veliertunc/industrial-comm-board/board.step

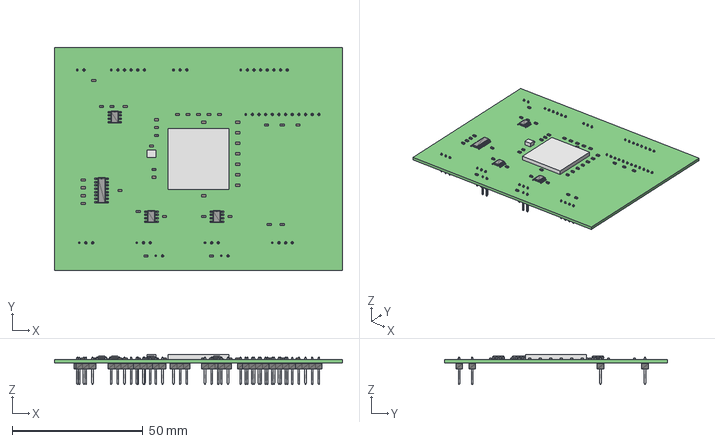
[picture p1: CAD file, 2026-11-03]
board.step
110.0 x 85.0 x 11.6 mm
