veliertunc/industrial-comm-board/output/pdf/industrial-comm-board.pdf

# STM32F746ZG / Industrial communication board

01 MCU and debug | 02 Power and clock | 03 Serial interfaces | 04 CAN and Ethernet | 05 Display, EEPROM and USB

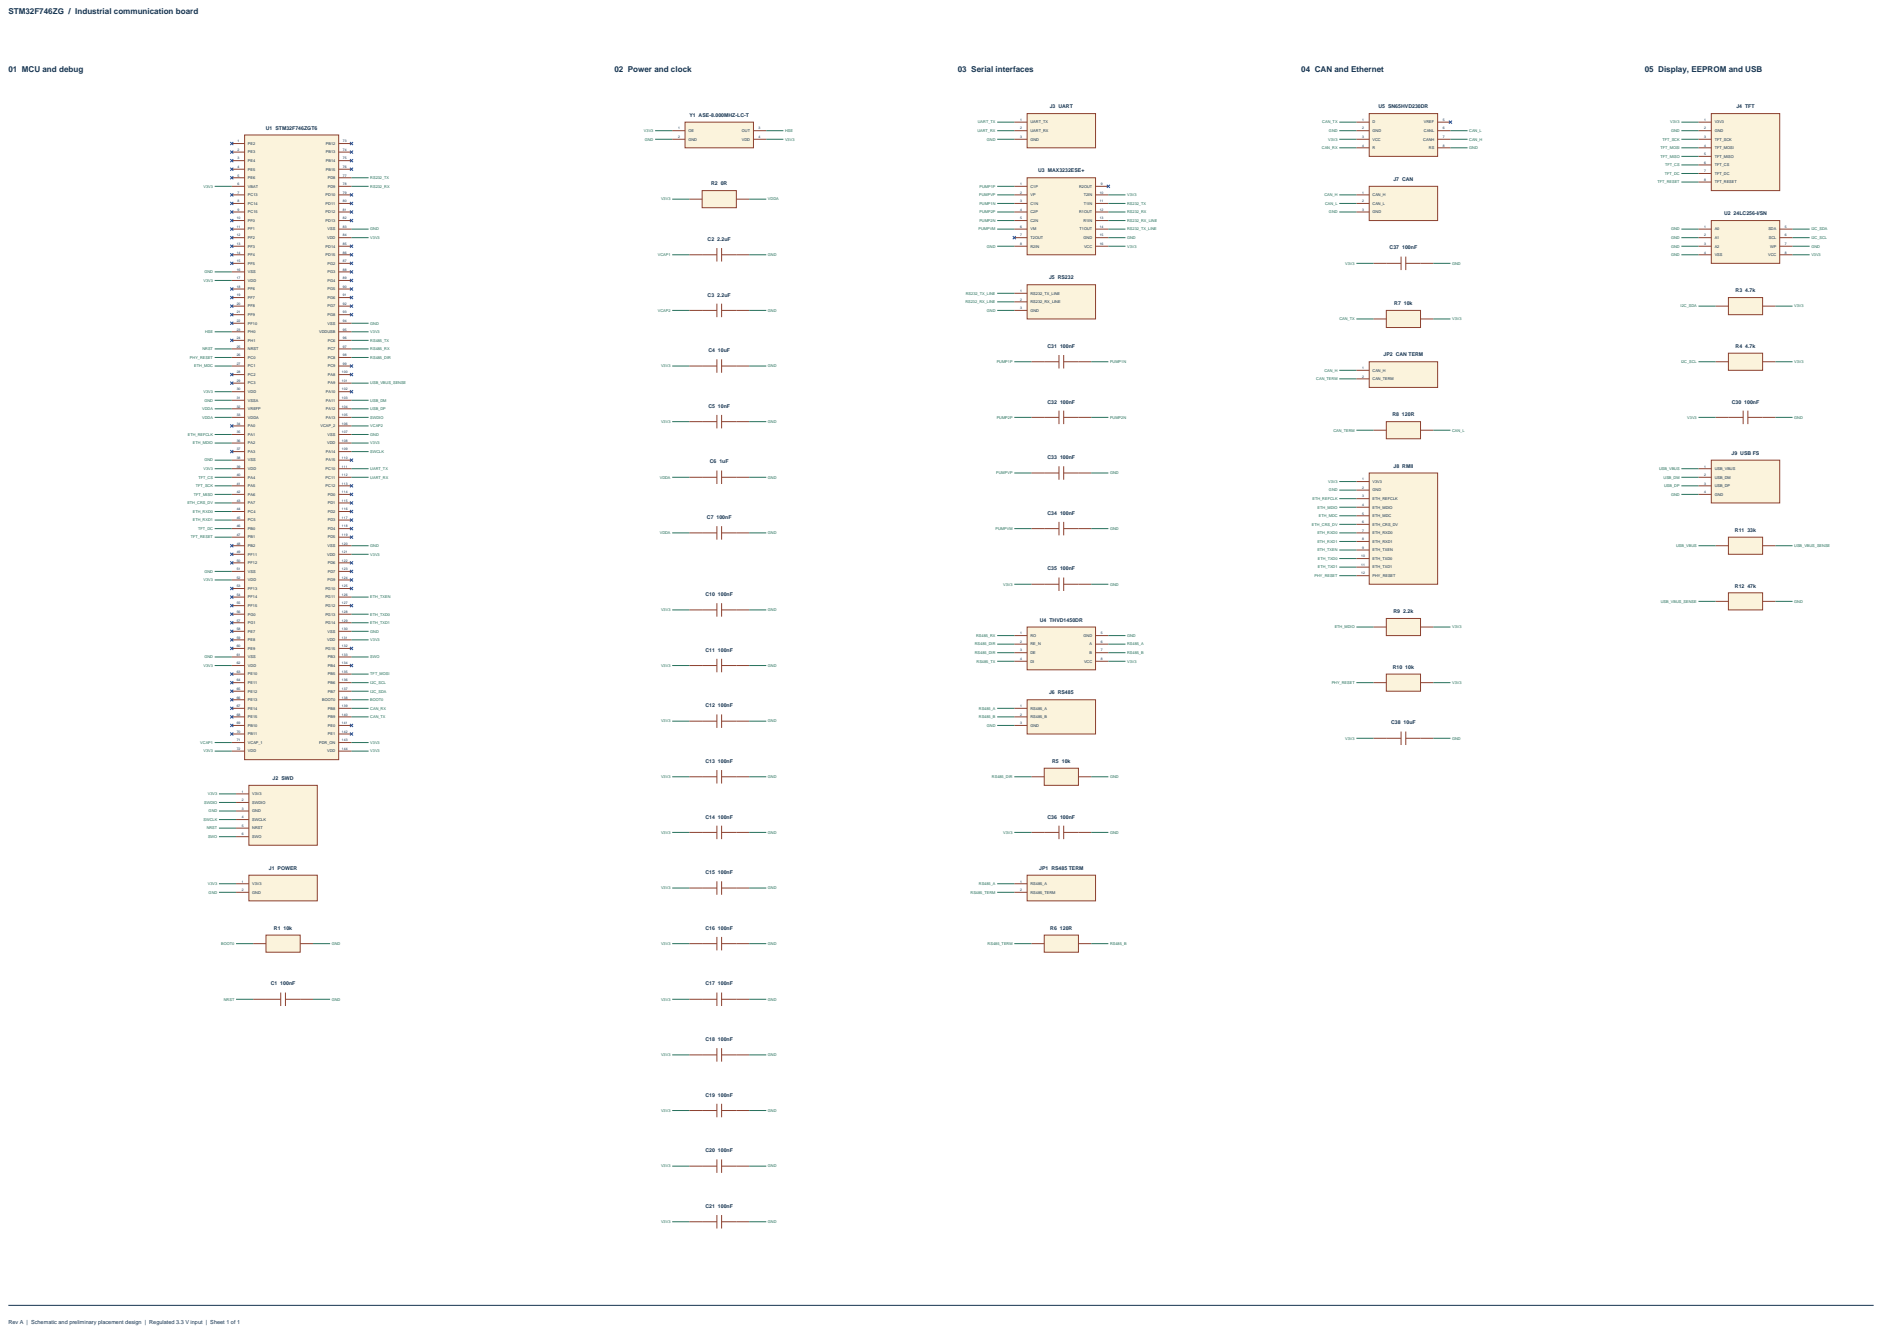
[picture p2: page 1]

Rev A | Schematic and preliminary placement design | Regulated 3.3 V input | Sheet 1 of 1
