veliertunc/industrial-comm-board/output/industrial-comm-board.kicad_sch

## KiCad design output/industrial-comm-board.kicad_sch (2026-11-03)

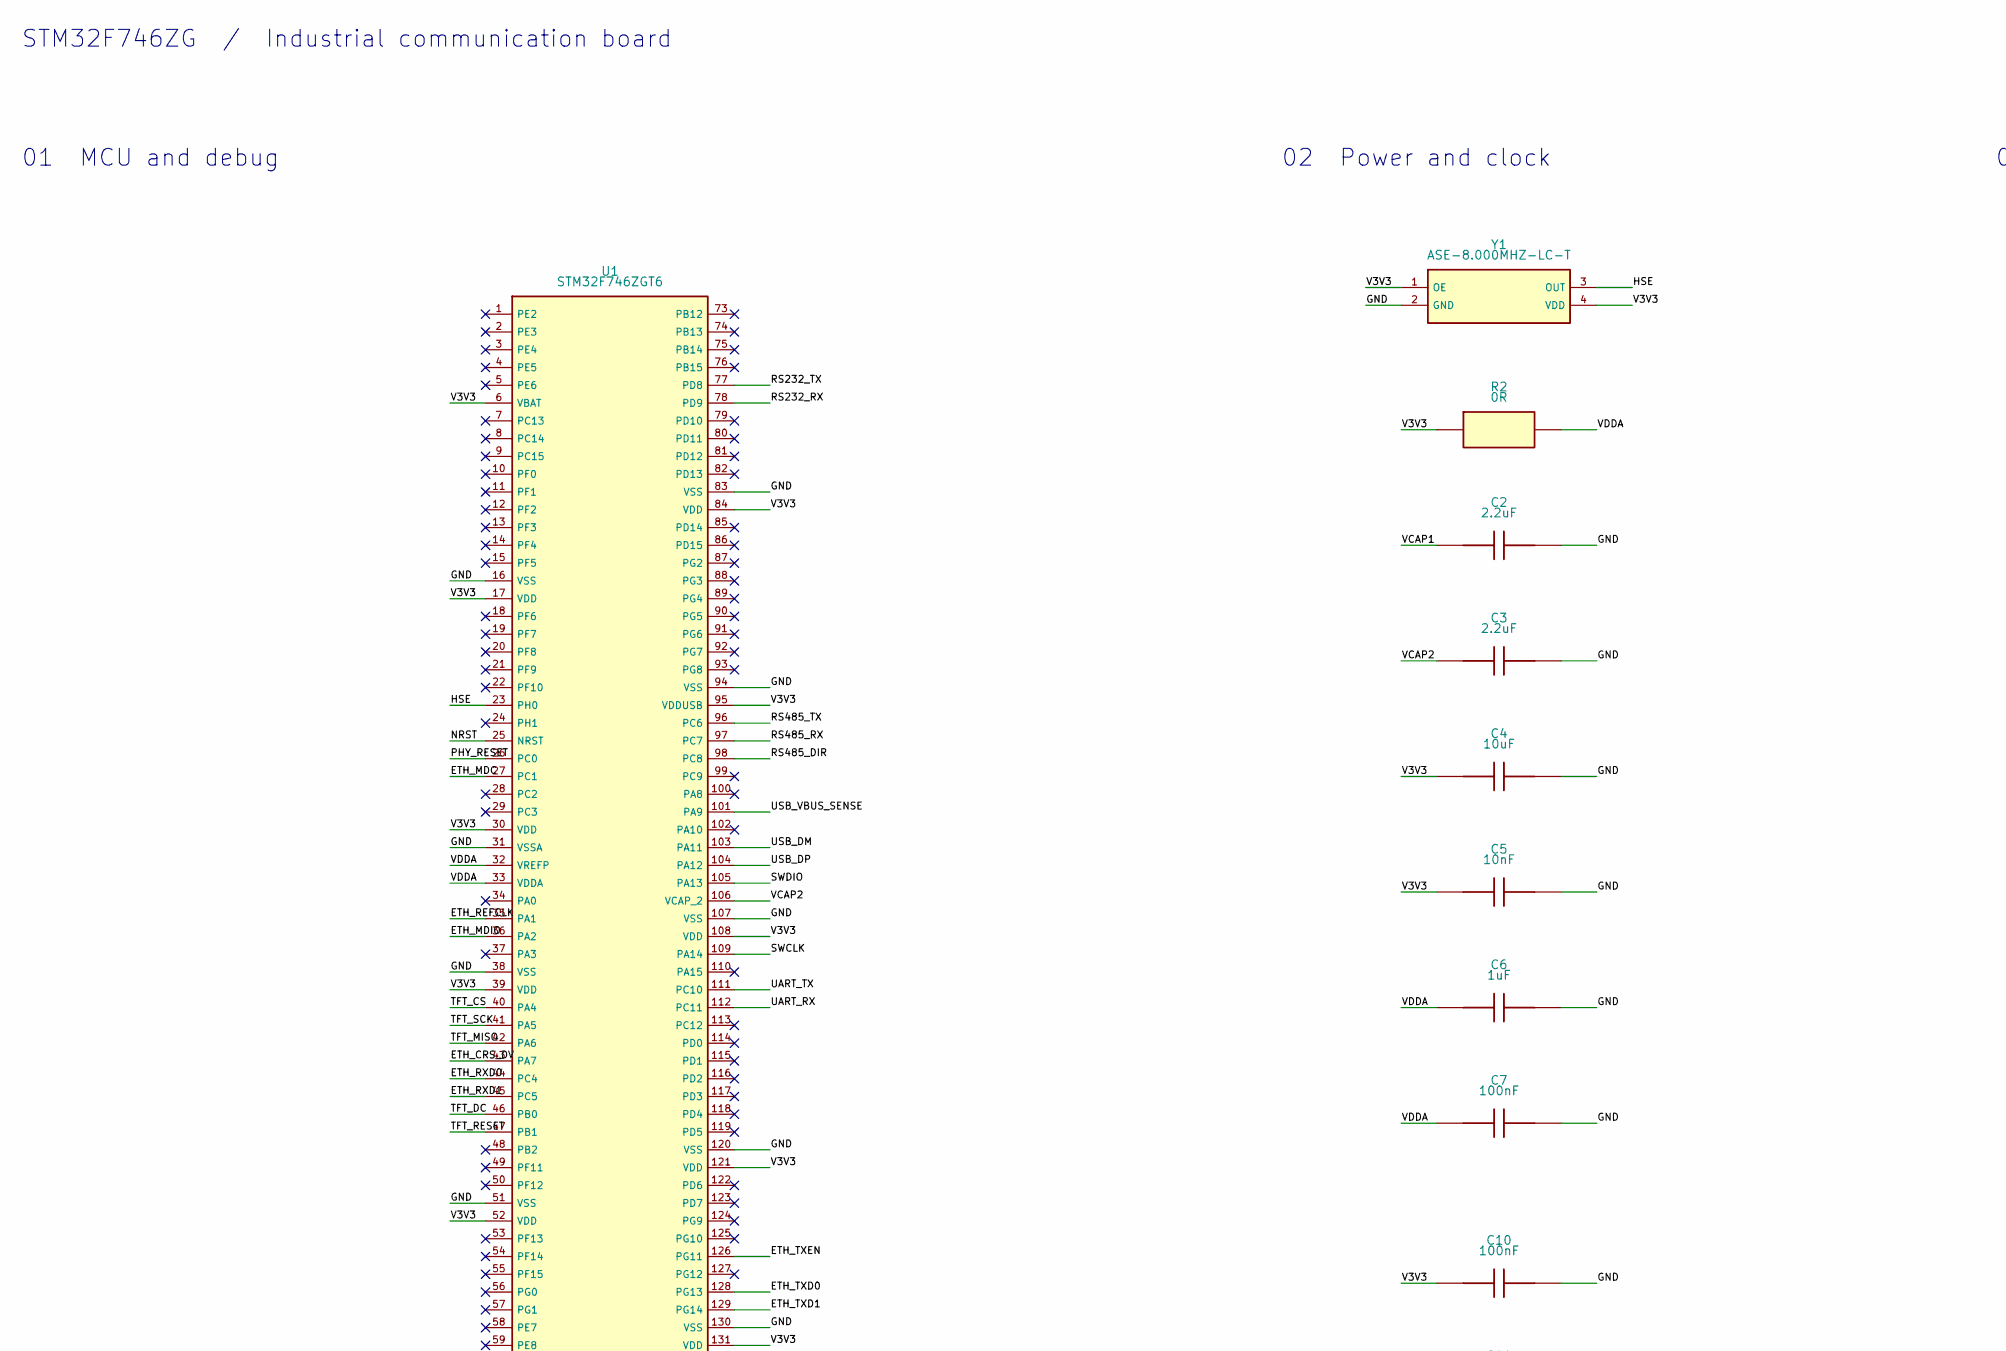
[picture p3: schematic industrial-comm-board.kicad_sch, part in row 1, column 1]

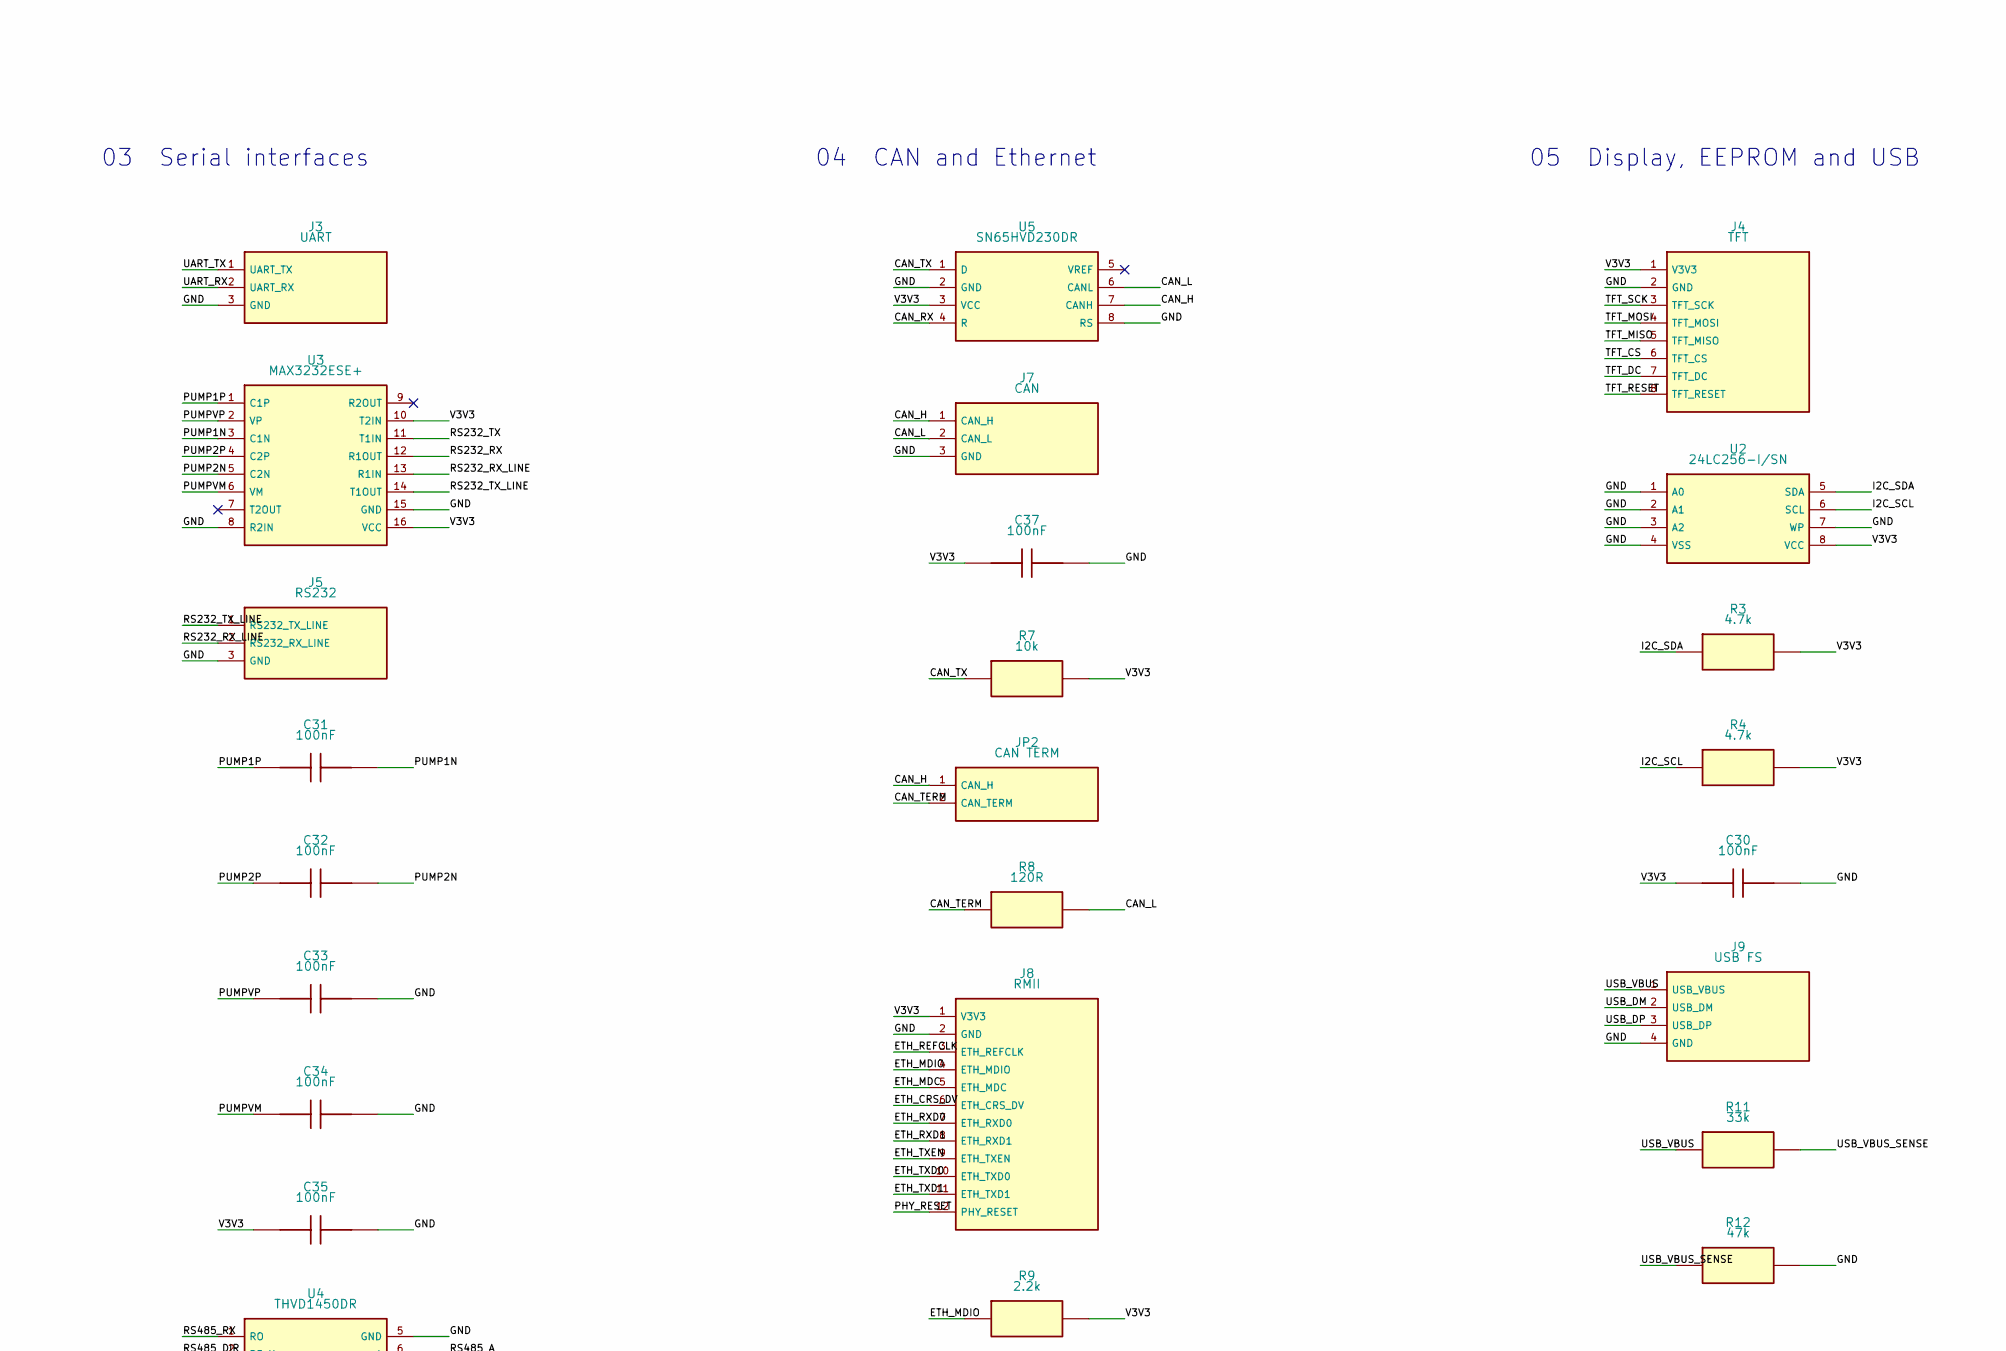
[picture p4: schematic industrial-comm-board.kicad_sch, part in row 1, column 2]

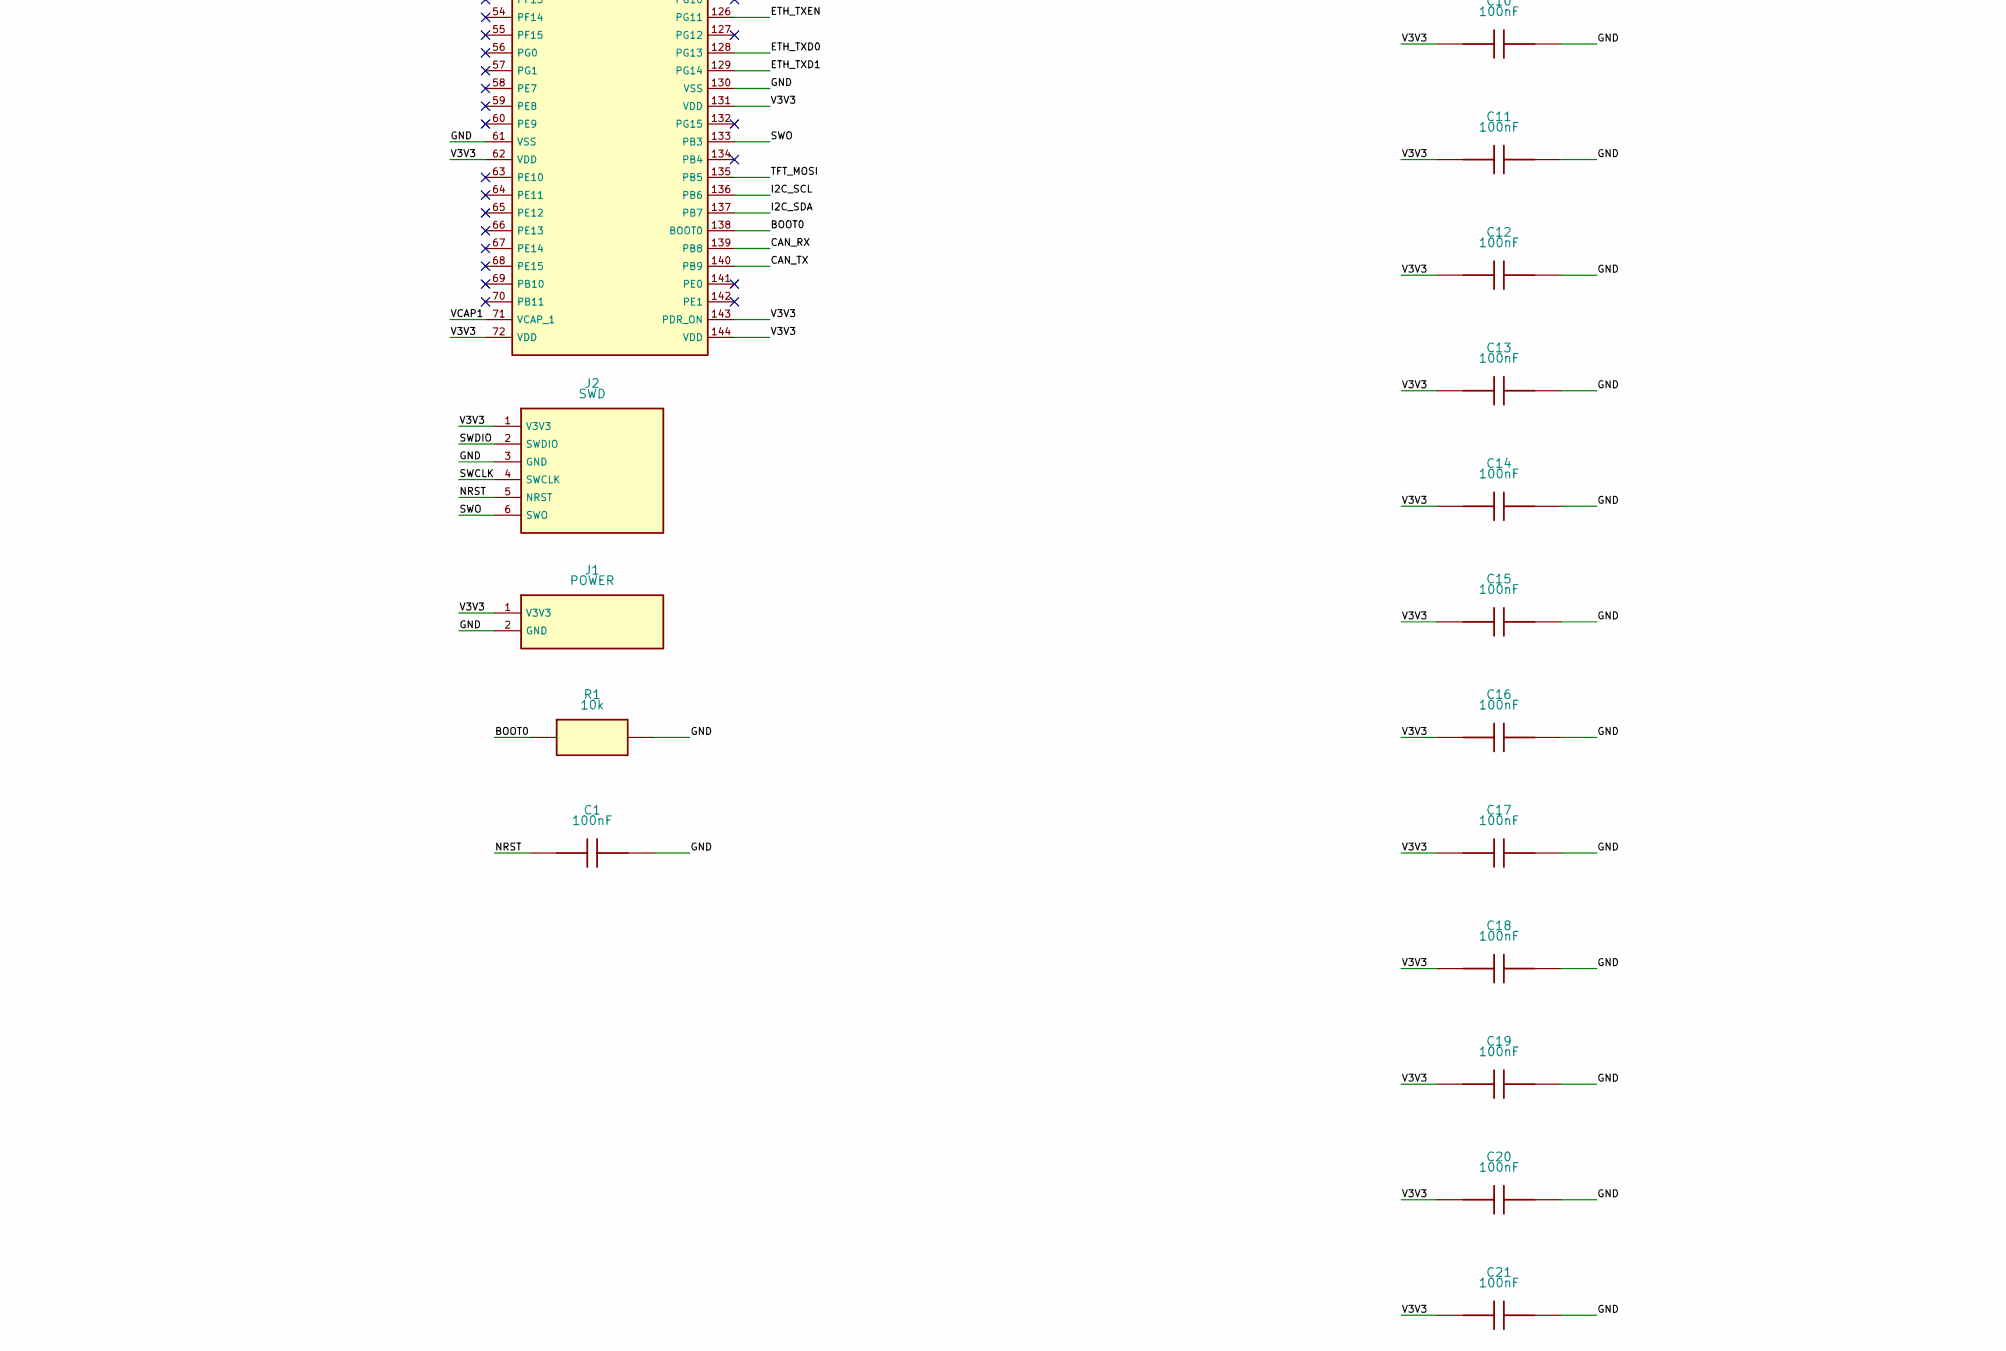
[picture p5: schematic industrial-comm-board.kicad_sch, part in row 2, column 1]

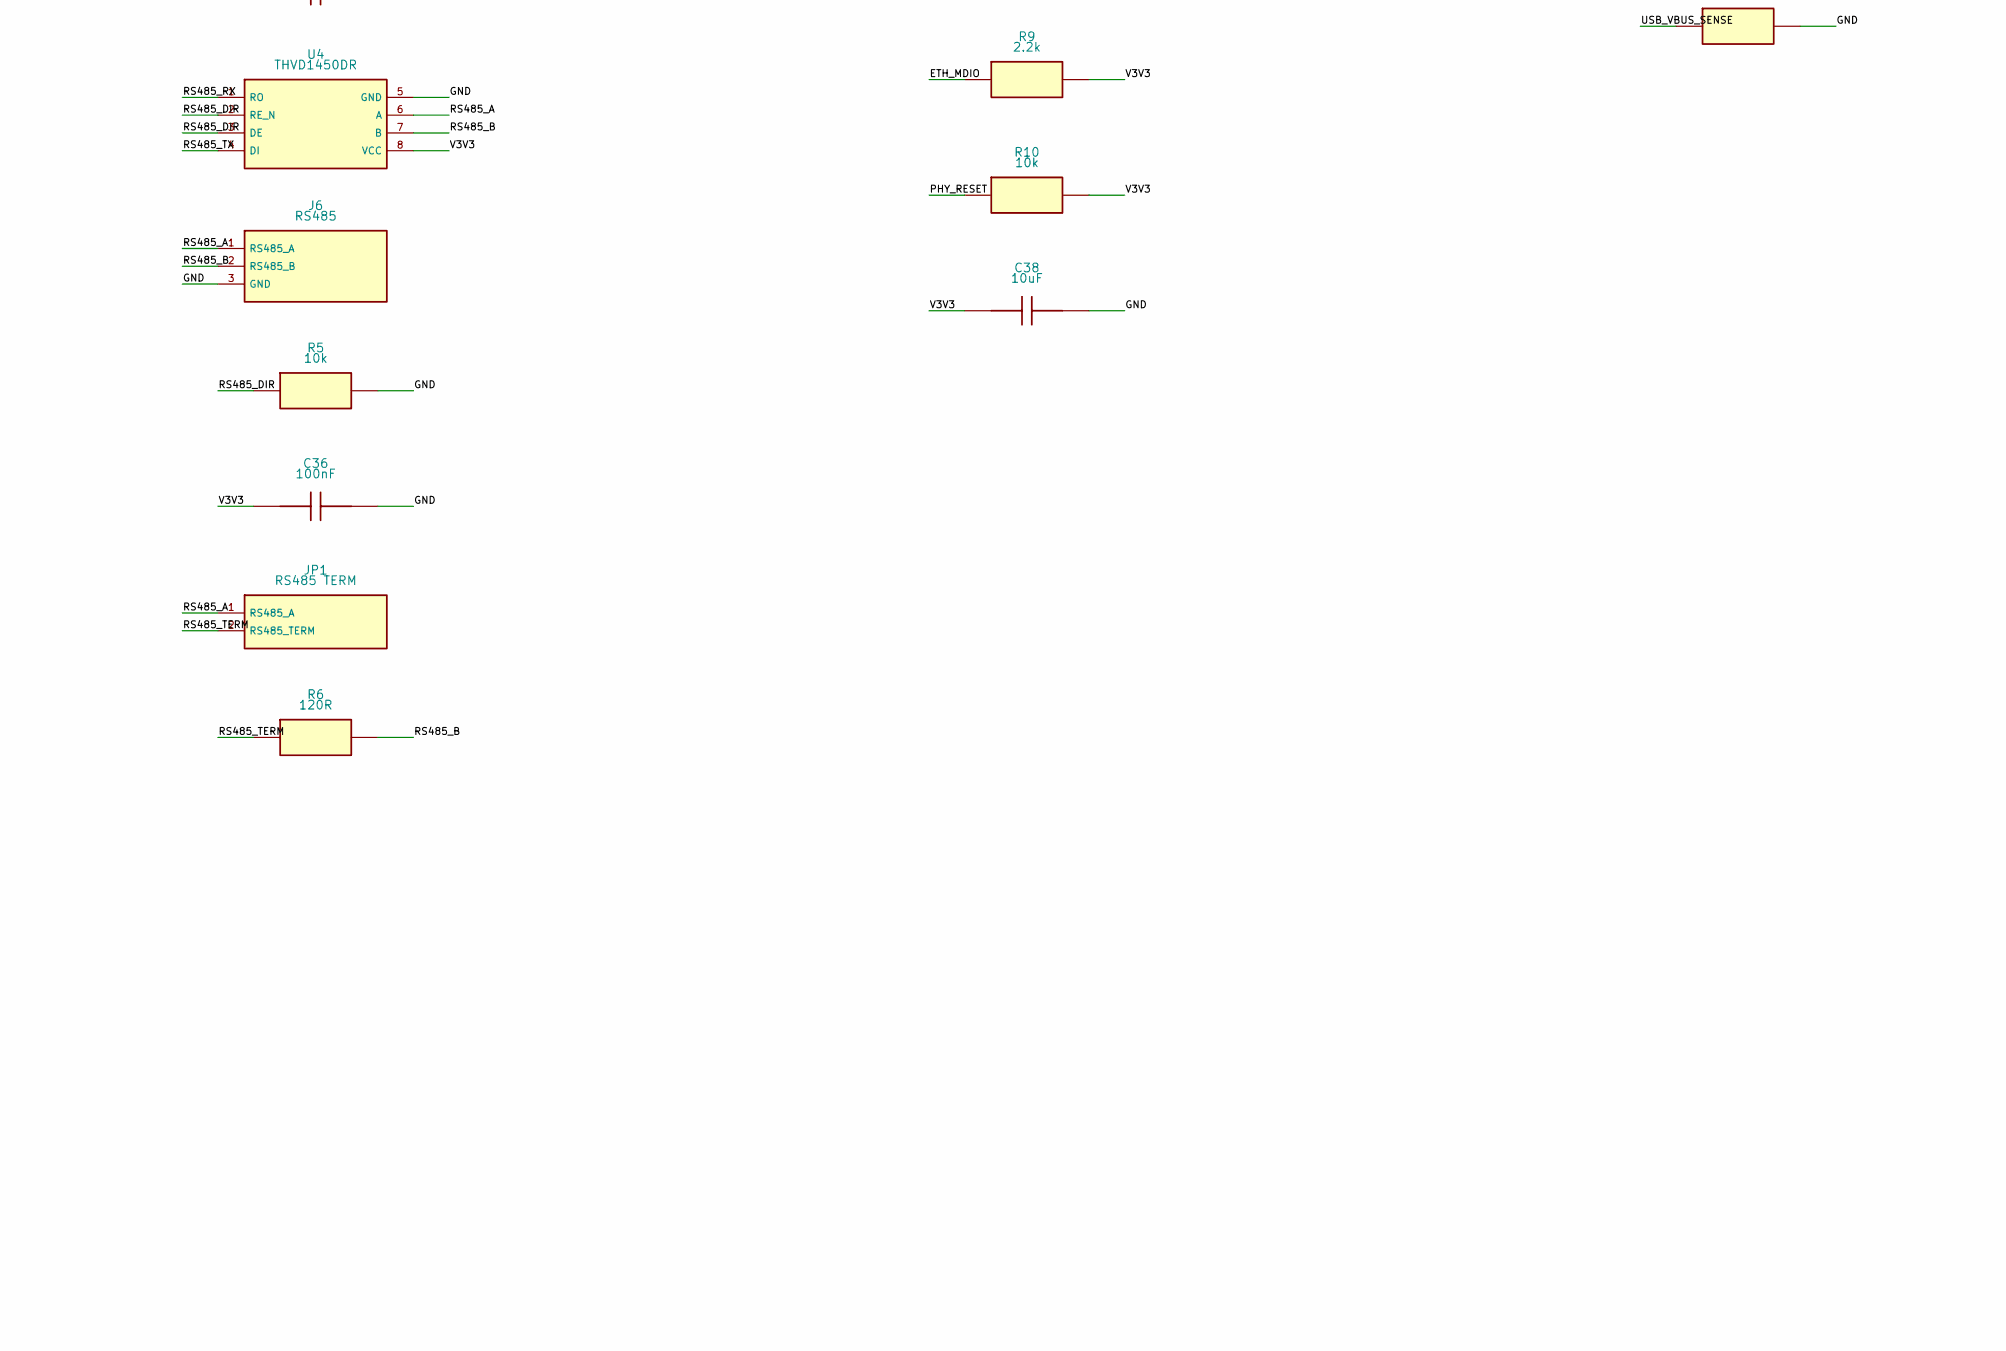
[picture p6: schematic industrial-comm-board.kicad_sch, part in row 2, column 2]

Parts:
C1, C7, C10, C11, C12, C13, C14, C15, C16, C17, C18, C19, C20, C21, C30, C31, C32, C33, C34, C35, C36, C37: 100nF
C2, C3: 2.2uF
C4, C38: 10uF
C5: 10nF
C6: 1uF
J1: POWER
J2: SWD
J3: UART
J4: TFT
J5: RS232
J6: RS485
J7: CAN
J8: RMII
J9: USB FS
JP1: RS485 TERM
JP2: CAN TERM
R1, R5, R7, R10: 10k
R2: 0R
R3, R4: 4.7k
R6, R8: 120R
R9: 2.2k
R11: 33k
R12: 47k
U1: STM32F746ZGT6
U2: 24LC256-I/SN
U3: MAX3232ESE+
U4: THVD1450DR
U5: SN65HVD230DR
Y1: ASE-8.000MHZ-LC-T

Connections:
BOOT0: R1.1, U1.138 (BOOT0)
CAN_H: J7.1 (CAN_H), JP2.1 (CAN_H), U5.7 (CANH)
CAN_L: J7.2 (CAN_L), R8.2, U5.6 (CANL)
CAN_RX: U1.139 (PB8), U5.4 (R)
CAN_TERM: JP2.2 (CAN_TERM), R8.1
CAN_TX: R7.1, U1.140 (PB9), U5.1 (D)
ETH_CRS_DV: J8.6 (ETH_CRS_DV), U1.43 (PA7)
ETH_MDC: J8.5 (ETH_MDC), U1.27 (PC1)
ETH_MDIO: J8.4 (ETH_MDIO), R9.1, U1.36 (PA2)
ETH_REFCLK: J8.3 (ETH_REFCLK), U1.35 (PA1)
ETH_RXD0: J8.7 (ETH_RXD0), U1.44 (PC4)
ETH_RXD1: J8.8 (ETH_RXD1), U1.45 (PC5)
ETH_TXD0: J8.10 (ETH_TXD0), U1.128 (PG13)
ETH_TXD1: J8.11 (ETH_TXD1), U1.129 (PG14)
ETH_TXEN: J8.9 (ETH_TXEN), U1.126 (PG11)
GND: C1.2, C2.2, C3.2, C4.2, C5.2, C6.2, C7.2, C10.2, C11.2, C12.2, C13.2, C14.2, C15.2, C16.2, C17.2, C18.2, C19.2, C20.2, C21.2, C30.2, C33.2, C34.2, C35.2, C36.2, C37.2, C38.2, J1.2 (GND), J2.3 (GND), J3.3 (GND), J4.2 (GND), J5.3 (GND), J6.3 (GND), J7.3 (GND), J8.2 (GND), J9.4 (GND), R1.2, R5.2, R12.2, U1.16 (VSS), U1.31 (VSSA), U1.38 (VSS), U1.51 (VSS), U1.61 (VSS), U1.83 (VSS), U1.94 (VSS), U1.107 (VSS), U1.120 (VSS), U1.130 (VSS), U2.1 (A0), U2.2 (A1), U2.3 (A2), U2.4 (VSS), U2.7 (WP), U3.8 (R2IN), U3.15 (GND), U4.5 (GND), U5.2 (GND), U5.8 (RS), Y1.2 (GND)
HSE: U1.23 (PH0), Y1.3 (OUT)
I2C_SCL: R4.1, U1.136 (PB6), U2.6 (SCL)
I2C_SDA: R3.1, U1.137 (PB7), U2.5 (SDA)
NRST: C1.1, J2.5 (NRST), U1.25 (NRST)
PHY_RESET: J8.12 (PHY_RESET), R10.1, U1.26 (PC0)
PUMP1N: C31.2, U3.3 (C1N)
PUMP1P: C31.1, U3.1 (C1P)
PUMP2N: C32.2, U3.5 (C2N)
PUMP2P: C32.1, U3.4 (C2P)
PUMPVM: C34.1, U3.6 (VM)
PUMPVP: C33.1, U3.2 (VP)
RS232_RX: U1.78 (PD9), U3.12 (R1OUT)
RS232_RX_LINE: J5.2 (RS232_RX_LINE), U3.13 (R1IN)
RS232_TX: U1.77 (PD8), U3.11 (T1IN)
RS232_TX_LINE: J5.1 (RS232_TX_LINE), U3.14 (T1OUT)
RS485_A: J6.1 (RS485_A), JP1.1 (RS485_A), U4.6 (A)
RS485_B: J6.2 (RS485_B), R6.2, U4.7 (B)
RS485_DIR: R5.1, U1.98 (PC8), U4.2 (RE_N), U4.3 (DE)
RS485_RX: U1.97 (PC7), U4.1 (RO)
RS485_TERM: JP1.2 (RS485_TERM), R6.1
RS485_TX: U1.96 (PC6), U4.4 (DI)
SWCLK: J2.4 (SWCLK), U1.109 (PA14)
SWDIO: J2.2 (SWDIO), U1.105 (PA13)
SWO: J2.6 (SWO), U1.133 (PB3)
TFT_CS: J4.6 (TFT_CS), U1.40 (PA4)
TFT_DC: J4.7 (TFT_DC), U1.46 (PB0)
TFT_MISO: J4.5 (TFT_MISO), U1.42 (PA6)
TFT_MOSI: J4.4 (TFT_MOSI), U1.135 (PB5)
TFT_RESET: J4.8 (TFT_RESET), U1.47 (PB1)
TFT_SCK: J4.3 (TFT_SCK), U1.41 (PA5)
UART_RX: J3.2 (UART_RX), U1.112 (PC11)
UART_TX: J3.1 (UART_TX), U1.111 (PC10)
USB_DM: J9.2 (USB_DM), U1.103 (PA11)
USB_DP: J9.3 (USB_DP), U1.104 (PA12)
USB_VBUS: J9.1 (USB_VBUS), R11.1
USB_VBUS_SENSE: R11.2, R12.1, U1.101 (PA9)
V3V3: C4.1, C5.1, C10.1, C11.1, C12.1, C13.1, C14.1, C15.1, C16.1, C17.1, C18.1, C19.1, C20.1, C21.1, C30.1, C35.1, C36.1, C37.1, C38.1, J1.1 (V3V3), J2.1 (V3V3), J4.1 (V3V3), J8.1 (V3V3), R2.1, R3.2, R4.2, R7.2, R9.2, R10.2, U1.6 (VBAT), U1.17 (VDD), U1.30 (VDD), U1.39 (VDD), U1.52 (VDD), U1.62 (VDD), U1.72 (VDD), U1.84 (VDD), U1.95 (VDDUSB), U1.108 (VDD), U1.121 (VDD), U1.131 (VDD), U1.143 (PDR_ON), U1.144 (VDD), U2.8 (VCC), U3.10 (T2IN), U3.16 (VCC), U4.8 (VCC), U5.3 (VCC), Y1.1 (OE), Y1.4 (VDD)
VCAP1: C2.1, U1.71 (VCAP_1)
VCAP2: C3.1, U1.106 (VCAP_2)
VDDA: C6.1, C7.1, R2.2, U1.32 (VREFP), U1.33 (VDDA)

Notes on the sheet:
STM32F746ZG / Industrial communication board
01 MCU and debug
02 Power and clock
03 Serial interfaces
04 CAN and Ethernet
05 Display, EEPROM and USB
