veliertunc/industrial-comm-board/(commit log)

2026-11-03 Add Schematic and PDF files
    [industrial-comm-board.kicad_sch]
2026-11-03 Add KiCAD library and project and STEP files
    [board.step]
2026-11-03 Add Gerber files
